BeiNuoKeLi/esp32-p4-module-dev-kit-Final-Report/doc/引脚定义.png

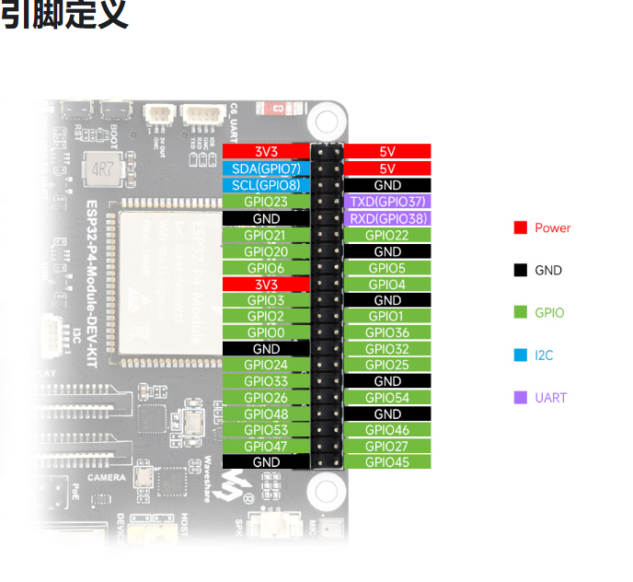
doc/引脚定义.png
