BeiNuoKeLi/esp32-p4-module-dev-kit-Final-Report/(commit log)

2026-05-20 官方例程仓库初始化
2026-05-20 禁用psram，成功运行hello world
2026-05-20 wifi模块跑通
2026-05-20 加入要求文档
2026-05-21 初步跑通光敏电阻
2026-05-21 fix：修复光敏问题，重新分配引脚
2026-05-31 温湿度传感器跑通
2026-05-31 跑通测温模块
2026-05-31 跑通器敏模块，增加提示词优化Skills
2026-05-31 chore: 同步dev分支的gitignore规则
2026-06-01 feat: 新增 OLED SSD1306 显示模块，修复 I2C 数据传输 Bug
    新增:
    - oled_ssd1306.c/h: SSD1306 I2C 驱动 (128x64 framebuffer, 6x8 字体)
    - 8 行实时传感器数据面板，1 秒刷新
    修复:
    - I2C 控制字节 0x40 与数据合并为单次事务发送 (修复屏幕无显示)
    - fb_write_char() 位掩码 0x3F→0xFF (修复字体顶部像素缺失)
    更新:
    - hello_world_main.c: 集成 OLED 显示任务，sensor_shared_t 共享数据
    - sensors.h: 新增传感器共享数据结构与互斥锁
    - CMakeLists.txt: 添加 oled_ssd1306 编译目标
    - 同步更新 memories.md / REQUIREMENT.md / p4_development_prompt_templates.md
    [oled_ssd1306.c, oled_ssd1306.h, sensors.h]
2026-06-01 feat：添加报警蜂鸣器
2026-06-01 完善开发手册和psram debug手册
2026-06-01 PSRAM: 启用并配置ESP32-P4 32MB PSRAM至最佳性能模式
    - 配置PSRAM为200MHz最高性能模式
    - 启用16线模式(HEX)、内存测试、BSS段放置在PSRAM
    - 禁用XIP模式以避免启动问题
    - 更新PSRAM_DEBUG_GUIDE.md为精简配置指南
    - 更新ESP32-P4-开发手册.md加入PSRAM配置信息
2026-06-01 fix: psram描述 dht11超时重启问题
2026-06-04 fix(sensors): MQ-135 预热检测 + 修复 ESP-Hosted SDIO 中断冲突
    问题描述：
    - MQ-135 上电瞬间 DO 输出不稳定，导致误报警
    - 初始化时访问 g_sensor_data 与 ESP-Hosted SDIO 中断冲突，
    引发 "Handler entered multiple times" 崩溃
    解决方案：
    - 实现预热检测：预热到 DO 稳定为 1（连续 5 次读数为 1）或最大 60 秒超时
    - 使用静态变量 s_mq135_warmed_up 替代共享结构字段，避免中断冲突
    - OLED 显示预热状态："MQ135: Warming..."
    - 预热期间 MQ-135 DO 不参与报警判断
    修改文件：
    - main/sensors.c: 预热逻辑实现，s_mq135_warmed_up 静态变量
    - main/sensors.h: 添加 mq135_is_warmed_up() 函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
    [sensors.c, sensors.h]
2026-06-04 恢复WiFi功能（注意只能连2.4G的网络）
2026-06-04 feat: 实现 UDP WiFi 数据传输 + 上位机 Python 接收端
    - 新增 udp_sender.c/h: JSON组包(snprintf) + UDP Socket(lwip) 发送，Task_UDP_Send(Core1,每2秒)
    - 新增 pc_receiver.py: UDP监听8080、JSON解析、控制台输出、CSV日志、报警红色高亮
    - hello_world_main.c: 创建 Task_UDP_Send (优先级2,栈4096,Core1)
    - 更新上位机IP: 192.168.5.5 → 10.16.234.215 (ipconfig 确认)
    - .gitignore: 忽略 sensor_log.csv 运行时日志
    - 同步 README/memories/REQUIREMENT/p4_templates 至当前状态
    - 端到端验证通过: ESP32(10.16.234.86) → PC(10.16.234.215):8080
2026-06-05 feat: 项目重命名 HelloWorld → SmartMonitor + 报警原因字段
    - CMakeLists: 项目名称改为 SmartMonitor
    - 全局替换旧路径 02_HelloWorld → SmartMonitor（含文档链接、README、REQUIREMENT）
    - main/smart_monitor_main.c: 主入口文件同步重命名
    - pytest_smart_monitor.py: 测试文件及函数名同步重命名
    - pc_receiver.py: 报警字段新增 reason 原因描述，CSV 日志同步追加 reason 列
2026-06-05 feat: 新增双色LED报警指示 + 继电器风扇控制 + OLED WiFi状态显示
    - 新增共阴极双色LED驱动 (GPIO26红/GPIO27绿)，正常绿灯亮，报警红灯亮
    - 新增继电器驱动 (GPIO32)，正常闭合风扇运转，报警断开风扇停止
    - OLED 行6 合并显示蜂鸣器+WiFi连接状态 (Buz/WiFi)
    - OLED 行7 显示继电器+LED状态 (Fan/LED)
    - 同步更新 REQUIREMENT.md、README.md、memories.md
2026-06-06 feat: 分级报警系统(L0-L3) + PC仿真注入GUI + 报警源A/B分类
    - 新增分级报警: L0正常/L1预警/L2严重/L3紧急, 支持持续超时升级
    - A类源(毒气/高温)联动风扇排风, B类源(光照/湿度)仅声光提醒
    - 新增PC仿真注入GUI工具, UDP 8081端口远程控制传感器值
    - JSON v2.0: 新增type/level字段, reason支持多源组合
    - pc_receiver.py: 分级颜色显示 + CSV新增type/level列
    - fix: 解除UDP发送任务Core1绑定, 修复ESP-Hosted SDIO中断冲突导致WDT超时崩溃
    [pc_receiver.py, sensors.h, smart_monitor_main.c, smart_monitor_sim_gui.py, udp_sender.c, udp_sender.h]
2026-06-06 feat(camera): 添加 KYT-U400 工业摄像头图像流采集与显示模块
    - 新增 camera_capture_sender.py: OpenCV DirectShow 采集, 640×360 MJPG 10fps
    Gamma 0.55 提亮 + Sharpen 0.2 锐化 + JPEG q=80 → UDP 4096B 分包
    - 新增 camera_display_receiver.py: UDP 收包 + 分片重组 + imshow 实时显示
    - 新增 camera_protocol.py: Magic 0xAA55 8字节协议头 (大端序, 可移植 C)
    - 新增 CAMERA_DEBUG_LOG.md: 8阶段调试历史 + 参数速查表
    - 更新 README.md / memories.md: 添加摄像头图像流通信参数和架构说明
    关键经验: 不覆盖 VideoCapture 硬件参数, 帧率用 last_send 基准计时,
    暗部用轻 gamma 补偿, JPEG>=80 避免块效应
2026-06-07 feat: Camera HTTP Relay + UDP 稳定性修复
    【新增】Camera HTTP 拉图中继模块 (camera_http_fetch.c/h)
    - ESP32-P4 从 ESP32-CAM 拉取 JPEG，通过 UDP 0xAA55 协议转发至 PC
    - Kconfig 配置: CAMERA_HTTP_ENABLED/FPS/ESP32CAM_URL/UDP_IP
    - CMake 添加 esp_http_client 依赖
    【修复】UDP 传输稳定性
    - ENOMEM 退避重试 (200ms × 3, pbuf 池耗尽保护)
    - Wi-Fi 轮询等待 (esp_netif_is_netif_up, 最长 20s)
    - 移除 SO_SNDBUF 设置 (避免 lwIP 配置冲突)
    - Camera 数据包间 5ms 微延迟 (缓解 pbuf 压力)
    【依赖更新】esp_wifi_remote 1.5.3 → 1.6.1
    【文档同步】README/PRODUCT_REPORT/memories/CAMERA_DEBUG_LOG 全面更新
    [oled_ssd1306.c, smart_monitor_main.c, udp_sender.c]
2026-06-07 feat(gui): 摄像头预览改为独立 Toplevel 窗口，修复 DHT11 时序
    - GUI: 摄像头预览从嵌入式 Label 改为独立可缩放窗口（640×480+），
    点击顶部「打开摄像头预览」按钮即可弹出，解决原 420×270 过小问题
    - sensors.c: DHT11 读取从固定延时法改为 1µs 粒度脉冲宽度测量，
    45µs 阈值区分 bit0/bit1，解决 ESP32-P4 上 ~95% 高电平超时
    - 新增 warehouse_db.py（SQLite 仓储模块）+ generate_qr_labels.py（二维码生成）
    - .gitignore: 忽略 warehouse.db（运行时数据库）和 qr_labels/（生成图片）
    - README.md: 新增「已知问题 & 修复」章节记录 DHT11 修复方案
    - PRODUCT_REPORT.md: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
    [generate_qr_labels.py, sensors.c, smart_monitor_sim_gui.py, warehouse_db.py]
2026-06-09 feat(web): 添加 Web 仪表盘初始版 (FastAPI + MQTT Bridge + Chart.js 前端)
    - 新增 docker/ 目录：Web 仪表盘容器化部署方案
    - app/main.py: FastAPI 后端，传感器数据接收/查询 API，WebSocket 广播
    - app/database.py: AIOSQLite 异步数据库 (sensor_data, inventory, check_log 表)
    - app/models.py: Pydantic 数据模型
    - app/static/dashboard.html: Chart.js 前端仪表盘
    - bridge/udp_to_web.py: UDP→HTTP 数据桥接
    - bridge/udp_sensor_sim.py: 传感器模拟器
    - Dockerfile + docker-compose.yml + requirements.txt
    - 更新 .gitignore: 排除 docker/data/ 和 汇报PPT/
2026-06-10 feat(v3.0): Web仪表盘Docker化 + DO数字输出监控 + 图表优化
    ESP32 端:
    - udp_sender.c: JSON 协议升级到 v3.0，新增 mq135_do/photo_do 字段
    - smart_monitor_main.c: DO 状态读取与报警逻辑联动
    Docker Web 仪表盘 (新增/重构):
    - main.py: FastAPI REST API + WebSocket 广播，传感器/出入库/摄像头接口
    - models.py: SensorData/SensorRecord/StatusResponse 新增 DO 字段
    - database.py: sensor_data 表新增 mq135_do/photo_do 列，异步入出库操作
    - filter.py: EMA 滤波 + 物理范围截断
    - camera_server.py/protocol.py: 摄像头 UDP 接收 + MJPEG 流 + pyzbar 扫码
    - dashboard.html: DO 状态彩色标签、4 图表 Y 轴固定量程、报警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
2026-06-10 feat(docker,frontend): 报警历史系统 + 视频流管理 + CameraWebServer 模块
    Backend (Docker):
    - 新增 alarm_events 表及完整 CRUD（database.py + models.py）
    - 新增报警去重逻辑（30s 窗口，级别变化即时触发）
    - 新增 GET/POST /api/camera/stream 视频流开关（pause/resume UDP 接收）
    - camera_server 新增 stream_enabled 开关和帧缓存优化逻辑
    - 新增 GET /api/alarms/* 系列端点（列表/详情/统计/确认）
    Frontend (dashboard.html):
    - 新增报警历史面板（分页表格 + 状态筛选 + 详情弹窗含 base64 快照）
    - 新增视频流开关控件 + FPS/帧数实时状态显示
    - 整体 UI 适配报警级别（level 0-3）联动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
    [partitions.csv]
2026-06-11 refactor(arch): 架构升级 — Docker 直连 ESP32-CAM, HVGA 画质优化, Canvas 前端重构
    - CameraWebServer: 分辨率 UXGA→HVGA (480x320), 简化配置逻辑, 修复 part_buf 声明
    - ESP32-P4: HTTP keep-alive 长连接复用, 优雅断线重连, UDP 中继默认关闭(已弃用)
    - Docker: 新增 HTTP 直连模式 (CAMERA_MODE=http), 替代 P4 UDP 中继, TCP 零丢包
    新增 CAMERA_MODE / ESP32_CAM_URL / CAMERA_HTTP_FPS 环境变量
    - 后端 API: 响应头添加 no-cache 策略 (Cache-Control/Pragma/Expires/X-Accel-Buffering)
    二维码扫描增加 CLAHE 局部直方图均衡, 增强边缘对比度
    - 前端 Dashboard: MJPEG <img> → Canvas 快照轮询 (消除 Chrome MJPEG 缓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
    [CameraWebServer.ino, app_httpd.cpp]
2026-06-13 feat: 仿真注入系统 + 报警管理增强 + v3.4 场景迁移至农资化肥
    - 新增内置 UDP 监听器 SensorUDPProtocol (替代外部桥接)
    - 新增 POST /api/sim/inject 仿真注入 API + 前端预设面板
    - 新增 DELETE /api/alarms 报警一键清空功能
    - 新增库存管理增强 (手动新增物料 / 流水清空 / 物料删除)
    - 新增 SimInjectRequest / SimStatus Pydantic 数据模型
    - 修复摄像头非仓库模式下未显示黑屏的问题
    - generate_qr_labels.py 重构支持 FERT-xxx 系列标签 --copies
    - warehouse_db.py 场景迁移：危化品 → 农资化肥
    - 文档同步更新至 v3.4 (PRODUCT_REPORT / README / REQUIREMENT / memories)
    [generate_qr_labels.py, smart_monitor_sim_gui.py, warehouse_db.py]
2026-06-13 feat(alarm,light): 运行时AO/DO报警配置、光敏ADC统一、多项修复
    BREAKING: light_v (float V) → light_raw (int ADC) 全栈统一; 旧warehouse.db需删除后重启。
    - feat: AO/DO双模式报警源选择（DO硬件比较器 / AO软件阈值判定）
    - feat: 温湿度报警独立开关，可单独关闭保留气体+光敏报警
    - feat: 报警配置面板UI + Web→MCU UDP双向同步
    - feat: NVS报警配置持久化 + SQLite镜像表(alarm_config)
    - fix: udp_sender报警逻辑与buzzer_task完全镜像，使用运行时配置
    - fix: buzzer_alarm任务栈溢出（2048→5120）
    - fix: sscanf JSON解析指针偏移错误导致全部配置值损坏
    - fix: 启动时NVS加载增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
    [CameraWebServer.ino, pc_receiver.py, sensors.h]
2026-06-14 feat: ESP32-CAM直推VPS + 端口映射8001-8003 + 文档同步
    - CameraWebServer.ino: loop() 改为主动 HTTP POST 推帧到 VPS (/api/camera/push)
    - camera_server.py: 新增 push_jpeg() + _push_dummy_loop() + CAMERA_MODE=push 分支
    - main.py: 新增 POST /api/camera/push 端点 (接收 ESP32-CAM 直推 JPEG)
    - docker-compose.yml: 端口映射 8001→8000/8002→8080udp/8003→8082udp, CAMERA_MODE=push
    - udp_sender.c: 目标改为 38.55.199.220:8002
    - camera_http_fetch.c: 目标改为 38.55.199.220:8003 (备用)
    docs: 同步 3 份文档 (README/PRODUCT_REPORT/REQUIREMENT)
    - API 路由表新增 POST /api/camera/push
    - 摄像头数据流新增 Push 模式章节
    - IP/端口更新为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
2026-06-14 fix: 修复摄像头FPS显示+UDP诊断日志+强制IP覆盖+文档同步
    - camera_server.py: push_jpeg() 补全 fps_history 记录，修复FPS始终为0
    - main.py: SensorUDPProtocol 前3帧+每10帧打印接收日志; _process_udp_sensor 异常时打印错误
    - docker-compose.yml: CAMERA_MODE=push→udp (ESP32-P4 UDP分包转发)
    - camera_http_fetch.c: CONFIG_CAMERA_HTTP_UDP_IP 改为 #undef 强制覆盖VPS IP
    - memories.md: 同步IP强制覆盖说明
    - 部署需加 --build 重构镜像; VPS防火墙需放行UDP 8002/8003
2026-06-14 feat: 相机按需推送/心跳模式 — 无观看者时省带宽 ~99.8% + 文档同步
    - ESP32-CAM: 读取 push 响应，push=false 时切心跳模式（每3s轻量GET /api/camera/push_status），不取帧不推图
    - camera_server.py: 新增 should_push 属性（stream_enabled and running）
    - main.py: POST /push 响应增加 push 字段；新增 GET /api/camera/push_status 心跳端点
    - docs: 更新 README/PRODUCT_REPORT API 路由表、数据流图、功能清单
2026-06-14 perf: 用 X-Push 响应头替代 JSON body 解析，消除 ESP32 每帧 String 开销
2026-06-14 perf: 修复 Web 显示逻辑 3 处潜在阻塞问题
    - P0 Canvas 快照轮询: 新增 _camFetching 背压标志，Image 解码完成前不发新 fetch，消除请求堆积 - P2 Chart.js: update() 改为 update('none') 跳过动画，减少主线程阻塞 10-50ms/次 - P3 camera_server: stream_enabled/paused 改为 property + _frame_lock 保护，消除线程安全问题
2026-06-14 perf: 切除 push 路径 cv2.imdecode 阻塞 — 帧率 0.9→20+ FPS + 消除 3s 延迟
    根因: cv2.imdecode (50-200ms CPU) 在 asyncio 事件循环线程同步执行，阻塞所有 HTTP 请求
    - camera_server: push_jpeg 改为直接存 JPEG bytes，不调 imdecode；新增 try_decode_frame 按需解码供 scan 使用
    - main.py: scan 端点改为 asyncio.to_thread(cam.try_decode_frame) 在线程池中解码
    - dashboard.html: 轮询调度移入 img.onload/onerror 回调，帧完全处理后才请求下一帧；轮询间隔 200→50ms
2026-06-14 feat: Camera 渲染链路深度优化 — MJPEG img 原生渲染替代 Canvas 轮询
    - docker-compose.yml: CAMERA_MODE=udp → push，启用 ESP32-CAM 直推模式
    - camera_server.py: _try_set_jpeg() 移除 cv2.imdecode 热路径（~50ms/帧），仅存 raw bytes + Event 通知
    - dashboard.html: 废弃 Canvas snapshot 轮询（~80行 JS），改用 img MJPEG 浏览器原生渲染
    - 端到端延迟：1-3s → <200ms
    - VPS CPU：消除 imdecode 开销；浏览器 CPU：消除 JS 解码+drawImage 开销
    - docs: PRODUCT_REPORT.md 升级至 v3.5，README.md 同步渲染架构描述；清除过时的 Canvas/UDP 引用
2026-06-14 fix: 修复MJPEG流延迟波动与画面卡顿
    - 服务端: 修复mjpeg_stream Event竞态(wait/clear窗口事件丢失)，keepalive间隔降至0.5s
    - 前端: fetch+ReadableStream手动拆帧替代<img>直连，绕过Chrome MJPEG解码器缓冲
2026-06-14 fix: 修复MJPEG二进制数据乱码，改用纯Uint8Array Buffer拆帧
2026-06-14 fix：修复无法注入
2026-06-14 feat: 仿真注入改为ESP32轮询拉取，绕过NAT入站限制
    - VPS: POST /api/sim/inject 改为暂存命令到 _pending_sim_cmd
    - VPS: 新增 GET /api/sim/poll?seq=N 供ESP32轮询
    - ESP32: 新增 sim_poll.c HTTP GET每3s拉取并解析JSON
    - 保留原UDP注入任务（局域网场景仍可用）
    - 前端提示文案适配轮询模式
2026-06-14 fix: sim_poll seq偏移量+5应为+6导致seq恒为0
2026-06-14 feat: 报警配置支持HTTP反转轮询，绕过NAT入站限制
    - VPS: 新增 _pending_alarm_cfg 暂存队列 + GET /api/alarm/config/poll 轮询端点
    - VPS: POST /api/alarm/config 双路径下发 (UDP快速路径+HTTP轮询可靠路径)
    - ESP32: sim_poll.c 新增 apply_alarm_config() 解析 config 命令并持久化到NVS
    - ESP32: sim_poll_task 双端点轮询 (sim=3s, config=10s), 独立seq去重
    - ESP32: save_alarm_config_to_nvs() 提升为外部可见函数供 sim_poll 调用
    docs: 更新 PRODUCT_REPORT.md API路由表/仿真数据流/配置同步描述
    docs: 更新 REQUIREMENT.md 文件结构/任务表/配置下发链路图
2026-06-14 fix: 报警配置增加启动同步机制，解决 ESP32 启动后拿不到 VPS 配置问题
    - VPS alarm_config_poll(): seq=0 且无待下发配置时，从 SQLite 返回当前配置作为初始同步（解决 Docker 重启后 _pending_alarm_cfg 内存队列清空问题）
    - ESP32 sim_poll.c: last_cfg_seq==0 时允许 seq>=0，确保启动配置可处理
    - ESP32 sim_poll.c: 新增报警配置轮询诊断日志（首次成功/失败均有输出）
    - docs: 更新 PRODUCT_REPORT.md 端到端同步说明为三路径
    - docs: 更新 REQUIREMENT.md 配置下发链路图，补充 v3.7 启动同步说明
    [sim_poll.c]
2026-06-14 feat: 摄像头传输升级为 TCP 二进制推流 (FPS 0.9→10-16, 延迟~3s→<300ms)
    - ESP32-CAM: WiFiClient TCP 长连接直推，帧格式 [2B big-endian len][JPEG]，消灭 HTTP POST 逐帧握手开销 (每帧省 500-1500ms TCP handshake)
    - VPS camera_server: 新增 _tcp_stream_loop() 二进制帧解析接收
    - docker-compose: CAMERA_MODE=tcp，复用 8003 端口替代废弃的 UDP 中继 (8003/udp→8003/tcp)
    - 保留 push_status 心跳：无观看者自动降速 1fps
    - docs: 更新 README.md/PRODUCT_REPORT.md 数据流图、端口表、模式说明
2026-06-14 perf: ESP32-CAM 推流 loop 精简为帧驱动模式 (仿 MJPEG stream handler)
    - 移除每 3s HTTP 心率阻塞 (省 200-500ms/轮，消除延迟抖动)
    - 移除速率限制，摄像头出帧即推
    - 移除 flush()，lwIP 自行控制 TCP 发送时机 (与 app_httpd.cpp 一致)
    - 代码从 80 行精简至 28 行，与 commit c11748b 的 MJPEG 原生性能对齐
2026-06-14 fix: 恢复 flush() + 增加串口诊断日志，排查 TCP 推流黑屏问题
    - 恢复 streamClient.flush()：lwIP 缓冲区满后帧堆积导致黑屏
    - 每 3s 输出诊断：帧数/FPS/丢帧/重连/WiFi状态/TCP状态/JPEG大小
    - 跟踪 write() 返回值检测不完整写入
    [CameraWebServer.ino]
2026-06-14 perf: JPEG quality 12→20，互联网推流 FPS 预期 2→5 且保持二维码识别
2026-06-14 perf: HVGA→QVGA (480x320→320x240), 帧大小减半消除卡顿, 二维码识别够用
2026-06-14 perf: JPEG quality 20→25, 目标帧大小 3-5KB 消除 FPS 抖动
2026-06-15 feat: ESP32-CAM 推流 TCP→UDP — 跨海吞吐 119x，零 RTT 窗口限制
    - CameraWebServer.ino: WiFiClient TCP 长连接 → WiFiUDP 分片推流 (v4.0)
    协议格式 [0xAA55+FrameID(u16)+ChunkIdx+TotalChunks][JPEG分片]
    单帧 3-8KB → 2-6 个 UDP 包 (≤1408B/包)，零连接开销
    - camera_server.py: 新增 CAMERA_MODE=udp_esp32 + _udp_esp32_loop()
    互联网适配: sock_timeout=10ms, frame_timeout=5s, early_render=1.0s
    复用 camera_protocol.py 0xAA55 协议头解析 + 分片重组
    - docker-compose.yml: 端口 8003/tcp→8003/udp, CAMERA_MODE=tcp→udp_esp32
    docs: 同步 README + PRODUCT_REPORT → v4.0
    - 摄像头数据流图 TCP→UDP 重绘，新增 udp_esp32 模式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
2026-06-15 fix: UDP分片接收调试日志 + light_raw类型int→float修复
    camera_server.py: _udp_esp32_loop增加原始字节诊断输出(Magic校验/包长度)
    models.py/database.py: light_raw字段从Optional[int]改为Optional[float]，解决Pydantic int_from_float 500错误
2026-06-15 fix: 修复f-string中反斜杠语法错误 (Python 3.11不支持)
2026-06-15 fix: UDP_CHUNK_SIZE 1400→1024，解决跨互联网MTU黑洞（大包丢失，仅273B小包到达）
2026-06-15 feat: VGA高清推流 + 抗丢包优化 chunk1280 quality15 delay2ms
2026-06-15 fix: HVGA高清 + 15fps限帧 + 移除分片调试日志(I/O阻塞) → 轻量简报
    [CameraWebServer.ino]
2026-06-15 fix: 不完整帧不再渲染残缺JPEG，保留旧帧防花屏闪黑
2026-06-15 fix: MJPEG流永不发送黑色占位图，latest_jpeg为None时复用上一帧好图
2026-06-15 fix: 占位图改为红色诊断——区分代码bug(红)和摄像头暗帧(黑)
2026-06-15 fix: 过滤<2.5KB暗帧，摄像头曝光抖动产出的极暗帧不再推流
2026-06-15 fix: 暗帧过滤阈值 2.5KB→4KB，HVGA正常帧≥6KB
2026-06-15 fix: 添加JPEG SOI(FFD8)完整性校验，拦截编码坏帧避免浏览器黑屏
2026-06-15 fix: 暗帧阈值4KB→8KB，精准拦截ESP32曝光振荡产生的5-6KB欠曝暗帧
2026-06-15 fix: VGA高清 + 暗帧阈值12KB精准拦截8-9KB欠曝暗帧
    [CameraWebServer.ino]
2026-06-15 fix: 用OpenCV像素亮度检测替代字节大小暗帧过滤，精确拦截黑屏闪烁
    - 新增 _is_dark_frame() 方法，使用 IMREAD_REDUCED_GRAYSCALE_4 缩略解码
    - 画面均值<30/255判定为暗帧，解决字节大小启发式漏检12-15KB暗帧问题
    - 缩略解码~5-10ms，仅为全尺寸解码的1/10
    - 无OpenCV时自动回退到原有12KB字节大小阈值
    - 暗帧诊断每50帧输出一次，避免日志刷屏
2026-06-15 debug: 添加亮度采样诊断，每50帧输出均值以校准暗帧阈值
    同时输出暗帧(🌑)和正常帧(✅)的实际亮度值 + JPEG字节大小，用于确定精准阈值
2026-06-15 debug: 提高亮度采样密度至每10帧，增加可疑低亮标记 + EMA均线追踪
    - 采样间隔 50→10 帧，捕获暗帧脉冲\n- 新增 SUS_THRESHOLD=45: 30-45标记为⚠️低亮可疑\n- EMA滚动均线追踪亮度基线\n- 仅<30的绝对黑帧执行拦截
2026-06-15 fix: JPEG完整性校验增加EOI(FFD9)检测，拦截尾部损坏帧防浏览器黑屏
    SOI+EOI双重校验确保JPEG完整有效，缺失EOI会导致浏览器解码失败渲染黑屏
2026-06-15 revert: ESP32固件回退HVGA，VGA黑闪根因在ESP32端非服务端
    - CameraWebServer.ino: FRAMESIZE_HVGA, quality=15, chunk=1024\n- 新增 VGA_DEBUG_LOG.md: 完整调试记录与根因推断\n- 服务端OpenCV亮度检测/JPEG校验/诊断采样 保留不变
    [CameraWebServer.ino]
2026-06-15 debug: 添加SKIP_CV2_BRIGHTNESS开关临时跳过OpenCV亮度检测，定位黑闪根因
    设为1时跳过cv2.imdecode，排除解码开销导致帧节奏紊乱的可能性
2026-06-15 debug: 添加 MJPEG 流诊断日志，排查浏览器黑屏根因
    在 yield 前打印 seq/size/new/stream 状态，用于定位黑屏时数据是否正常发出
2026-06-15 fix: 修复 MJPEG 前端解析双 bug 导致浏览器黑屏
    1. 搜索串改为 --frameboundary(15B)，避免首帧因缺少前导\r\n被跳过
    2. 帧尾定界改用下一个boundary位置精确切帧，替代buf.length-2的硬裁切
    3. camera_server.py 移除诊断日志，还原至原始状态
2026-06-15 docs: 同步前端渲染架构至各文档，新增调试方法论
    PRODUCT_REPORT.md / README.md: MJPEG <img>原生渲染 → ReadableStream+BlobURL逐帧渲染
    VGA_DEBUG_LOG.md: 补充最终根因（前端双bug）及诊断实验回顾
    memories.md: 新增2026-06-15条目 + DEBUG_GUIDE索引
    DEBUG_GUIDE.md: 新增数据流分界实验法（三步探针+五条铁律）
2026-06-15 feat: 二维码识别全链路优化 — 4 方案同步落地
    P0 | Docker API 多帧重试：单帧→3 帧×80ms + 重复帧 hash 跳过，识别率大幅提升
    P1 | ESP32-CAM OV2640 传感器调优：contrast=2 锐化边缘 + aec2 快速曝光 + gainceiling=2X 降噪
    P2 | GUI 仓管扫码对齐：补 CLAHE + 3×3 锐化核滤波，冷却 2s→0.5s 支持高频扫码
    P3 | QR 标签抗污损升级：version 3→4 (29→33 模块) EC M→H (15%→30% 纠错)
    docs: 同步扫码全链路参数至 PRODUCT_REPORT.md / README.md（冷却、重试、OV2640、QR 版本纠错）
2026-06-15 feat: 一键清除全部库存（Python GUI + Web 仪表盘双端支持）
    - warehouse_db.py: 新增 clear_all() 方法，DELETE FROM inventory + check_log 并返回删除记录数
    - smart_monitor_sim_gui.py: Tab 2 表底栏「🗑 一键清除全部库存」红色按钮，含二次确认弹窗
    - docker/app/database.py: 新增 clear_inventory() 异步函数（aiosqlite）
    - docker/app/main.py: 新增 DELETE /api/inventory 端点，返回已删除记录数
    - docker/app/static/dashboard.html: 库存清单标题栏「🗑 一键清除库存」按钮 + clearAllInventory() JS 函数
    - docs: README 补全一键清除库存功能说明
2026-06-15 feat: 演示锁定机制 — 每浏览器独立 Cookie 锁
    - 后端新增 demo_lock_middleware HTTP 中间件，拦截所有写操作 (POST/PUT/DELETE)
    - Cookie 值使用 HMAC-SHA256 签名防伪造，hmac.compare_digest 防时序攻击
    - ESP32 设备通信白名单 (/api/sensors, /api/camera/push, /api/sim/poll 等) 不受锁定影响
    - 新增 3 个认证端点: POST /api/auth/unlock, POST /api/auth/lock, GET /api/auth/status
    - 前端 Header 新增 🛡️ 锁定指示器 + 密码弹窗 (输错震屏动画)
    - 14 个写操作函数添加 checkUnlock() 守卫
    - docker-compose.yml 新增 DEMO_PASSWORD=111 环境变量
    docs: 补全 PRODUCT_REPORT.md 路由表 + memories.md 架构与更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
2026-06-15 fix: auth/unlock JSONDecodeError — 请求体解析失败时返回 JSON 而非 500 HTML
    - try/except 包裹 request.json() 防止异常抛 HTML 页面
    - 宝塔反向代理场景下 POST body 可能被截断导致 parse 失败
    docs: README 新增服务器一键重建命令
2026-06-15 fix: 认证端点被自身中间件拦截 — auth 端点加入白名单
    - /api/auth/unlock|lock|status 未在白名单，中间件在认证前就返回 403
    - 导致用户永远无法解锁（鸡生蛋问题）
    - 将 3 个 auth 端点加入 _LOCK_WHITELIST
2026-06-15 fix: 占位图红色诊断→黑色默认 + Cookie API 兼容修复
    - 恢复 camera_server.py 占位 JPEG 为纯黑色 (撤销 2b31637 的红色诊断改色)
    - main.py: raw_headers.append() → set_cookie()/delete_cookie() 标准 API，兼容老版 Starlette
2026-06-15 fix: JSONResponse 缺失导入导致 auth/unlock 500 Internal Server Error
    - 顶部 import 漏了 JSONResponse，认证端点 runtime NameError 触发 500 HTML 页面
    - 删除 camera_push 内冗余的局部 import
2026-06-15 feat: 手机端响应式适配 — 900/600/480 三级断点全布局优化
    - CSS: 3 级断点 @media(900/600/480) 覆盖全屏→平板→手机
    - sim-panel: 6列→3→2列, cat-stats-row: 4列→2→1列, g4: 4→2→1列
    - 弹窗: lock-modal-box width:90vw+max-width, rawDataPanel min(420px,94vw)
    - 表格: #inventoryTable/.alarm-panel overflow-x:auto 防止 12 列溢出
    - 字体/按钮/图表/header 逐级缩小，480px 隐藏报警原因文字
    docs: memories.md 追加手机端适配记录
2026-06-16 refactor(p4): 健壮性修复 + 移除已弃用摄像头 HTTP 中继模块
    - 删除已弃用摄像头模块：camera_http_fetch.c/h、CAMERA_DEBUG_LOG.md
    - 清理 Kconfig/sdkconfig/CMakeLists.txt 中摄像头配置项
    - ADC 初始化去 ESP_ERROR_CHECK：adc1_shared_init() 改为返回错误码
    - 传感器任务（mq135/ds18b20/dht11/photo）init 失败改为循环重试+设置 err 标志
    - buzzer_task 蜂鸣器 init 失败不退出，继续初始化 LED/继电器，降级运行
    - sim_poll WiFi 等待改为无限循环，避免任务退出导致轮询永久丢失
    - udp_sender sendto 非 ENOMEM 错误时关闭重建 socket，避免资源泄漏
    - docs: 修正任务数量 8→9，补充 JSON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
    [sensors.c, sim_poll.c, smart_monitor_main.c, smart_monitor_sim_gui.py, udp_sender.c, udp_sender.h]
2026-06-16 feat: 仓储与报警数据 WebSocket 实时同步，多客户端即时刷新
    代码层：
    - main.py: 新增 _broadcast_warehouse_update() / _broadcast_alarm_update()
    两个广播辅助函数，在所有仓储写 API（入库/出库/新增/删除/清空/清流水）
    和报警写 API（确认/清空）成功后通过 WebSocket 广播通知所有在线客户端
    - _process_udp_warehouse(): UDP 出入库路径同样加入成功广播
    - dashboard.html: WebSocket onmessage 新增 warehouse_update 和
    alarm_update 消息类型消费，即时调用 refreshWH() / loadAlarmSummary()
    docs: PRODUCT_REPORT.md 新增 2.4 节 WebSocket 实时推送协议，完整
    文档化 4 种消息类型的触发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
2026-06-16 feat: 统一 MQ-135/光敏 AO 阈值为 ADC raw 单位，消除 V↔raw 单位歧义
    - MQ-135 阈值从 float V (2.5) 改为 int ADC raw (3100)，与光敏一致
    - JSON 新增 mq135_raw 字段 (0~4095)，保留 mq135_v 向后兼容
    - Dashboard 卡片/滑块/图表/仿真预设全部改为 raw 单位
    - OLED 显示从 「%.2fV」 改为 「%-4draw」
    - EMA 滤波新增 mq135_raw alpha=0.15，响应速度对齐光敏
    - NVS Key mq_ao_thr→mq_ao_raw，避免旧 mV 值冲突
    - DB 新增 mq135_raw 列 + 自动迁移 + alarm_config 阈值 INTEGER→3100
    - camera_server.py: 多客户端独立帧队列，解决慢客户端拖慢全局延迟
    docs: 同步 README/PRODUCT_REPORT/REQUIREMENT/memories 至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
2026-06-16 fix: alarm_config 旧 V 阈值迁移 + get_alarm_config int 兜底
    旧 SQLite alarm_config 表 mq135_ao_threshold 为 REAL 2.5，新 Pydantic 模型要求 int，导致 GET /api/alarm/config 校验失败。
    - 新增迁移: UPDATE alarm_config SET mq135_ao_threshold=3100 WHERE <100
    - get_alarm_config() 增加 int() 兜底转换
2026-06-16 fix: WebSocket 广播 + 模型补全 mq135_raw，旧数据自动反算
    1. _ingest_sensor_data: mq135_raw 缺失时从 mq135_v 反算
    2. WebSocket sensor_update 广播新增 mq135_raw 字段
    3. SensorRecord/StatusResponse/AlarmEvent 模型补充 mq135_raw
    4. 旧 ESP32 固件/历史数据无 raw 时自动兼容
2026-06-23 docs: 禁用 PSRAM，新增压力测试工程与完整调试文档
    - sdkconfig: PSRAM 禁用 (v1.0 + ESP-Hosted 双核 RPC 并发 malloc 崩溃)
    - PSRAM_DEBUG_GUIDE.md: 重写，记录 3 种频率 x 4 配置 x 7 项测试全结论
    - BUG_REPORT_PSRAM.md: 新建，待提交 ESP-IDF 官方 issue
    - psram_test/: 新建独立 PSRAM 压力测试工程 (7 项访问模式)
    - smart_monitor_main.c: 修复 NVS u32 编译器警告 + 网络任务延迟到 WiFi 就绪后创建
    [smart_monitor_main.c]
2026-06-23 fix: HTTP open 失败时关闭 socket 防泄漏，加连续失败退避
    - esp_http_client_open 失败路径补 close 防 transport 层 socket 泄漏
    - 连续 HTTP 失败 >2 次延迟 2s，>5 次延迟 5s，避免耗光 LWIP socket 池
    [sim_poll.c]
2026-06-23 fix: HTTP 失败退避 + 超 20 次冷却 60s 防 VPS rate-limit
    [sim_poll.c]
